Sundsturm/Analogue-PPG-Filter_13222083/PROYEK-1_SIM.asc

C1: cap; 10µ
C2: cap; 10µ
C6: cap; 4.7µ
C7: cap; 10µ
C8: cap; 10µ
R1: res; 82k
R2: res; 330k
R5: res; 1k5
R7: res; 3k7
R_X: res; 10k
RF_X: res; 100k
V1: voltage; 10
V2: voltage; 10
V3: voltage; SINE(100m 1 1k); AC 5; Rser=50
X1: Opampku
X2: Opampku
X3: Opampku
X8: Opampku
Named nets: 0, VCC, VEE, Vi, Vo_f, Vo
Aturan:
1. Nilai-nilai resistor diatur dengan maksimal 3 kombinasi resistor;
2. Nilai-nilai kapasitor tetap; dan
3. Digunakan op-amp LM741 dan model op-amp berasal dari praktikum.
.ac dec 100 0.001 1k
Noninverting Amplifier
Sallen-Key LPF
MFB HPF
